maslohaslo1234-spec/DC-motor/BOM.csv

Item | Qty | Supplier | Cost/item | Total Cost | link
Enamelled copper wire 0.25 mm | 1 | AliExpress | $11.40 | $11.40 | https://pl.aliexpress.com/item/1005001693901095.html?pdp_ext_f=%7B"order"%3A"410"%2C"eval"%3A"1"%2C"fromPage"%3A"search"%7D&pdp_npi=6%40dis%21PLN%2150.60%2147.06%21%21%2183.75%2177.89%21%40210382de17941563686217380e0ccc%2112000017170269244%21sea%21PL%216848615415%21X%211%210%21n_tag%3A-29919%3Bd%3A71f28d94%3Bm03_new_user%3A-29895%3BpisId%3A5000000220770329&curPageLogUid=fweTSyffKTfp&utparam-url=scene%3Asearch%7Cquery_from%3A%7Cx_object_id%3A1005001693901095%7C_p_origin_prod%3A&gatewayAdapt=glo2pol
A3144 Hall sensor | 1 | AliExpress | $1.95 | $1.95 | https://pl.aliexpress.com/item/1005007195591707.html?mp=1
608ZZ bearings | 1 | AliExpress | $5.62 | $5.62 | https://pl.aliexpress.com/item/1005008528575310.html?pdp_ext_f=%7B"order"%3A"63"%2C"eval"%3A"1"%2C"fromPage"%3A"search"%7D&pdp_npi=6%40dis%21USD%216.22%215.62%21%21%2141.24%2137.25%21%402103956a17941568683062633e0e8b%2112000045574006522%21sea%21PL%216848615415%21X%211%210%21n_tag%3A-29919%3Bd%3A71f28d94%3Bm03_new_user%3A-29895&curPageLogUid=xlfpEw6IfKr7&utparam-url=scene%3Asearch%7Cquery_from%3A%7Cx_object_id%3A1005008528575310%7C_p_origin_prod%3A
Neodymium disc magnets 10 x 3 mm N52 | 1 | AliExpress | $8.36 | $8.36 | https://pl.aliexpress.com/item/1005010805205054.html?pdp_ext_f=%7B"order"%3A"238"%2C"eval"%3A"1"%2C"fromPage"%3A"search"%7D&pdp_npi=6%40dis%21USD%213.51%213.14%21%21%213.51%213.14%21%400b15834017941571913294615e0cb6%2112000053556705897%21sea%21PL%216848615415%21X%211%210%21n_tag%3A-29919%3Bd%3A71f28d94%3Bm03_new_user%3A-29895&curPageLogUid=AB1SDarjmCf2&utparam-url=scene%3Asearch%7Cquery_from%3A%7Cx_object_id%3A1005010805205054%7C_p_origin_prod%3A
Estimated total shipping | 1 |  |  | $2.50
