maslohaslo1234-spec/DC-motor/cad/STEP/Assembly 1.step

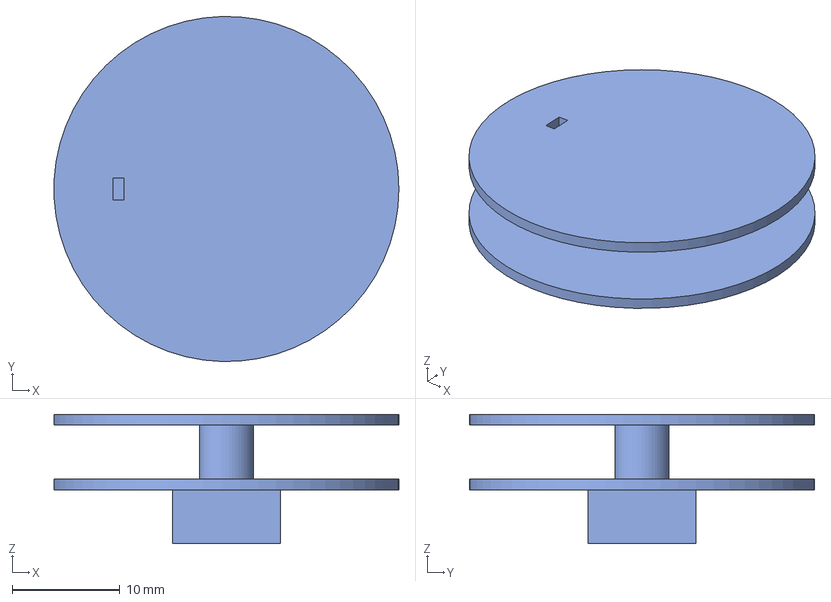
[picture p1: CAD file, 2026-11-08]
cad/STEP/Assembly 1.step
32.0 x 32.0 x 12.0 mm
