maslohaslo1234-spec/DC-motor/cad/STEP/rotor.step

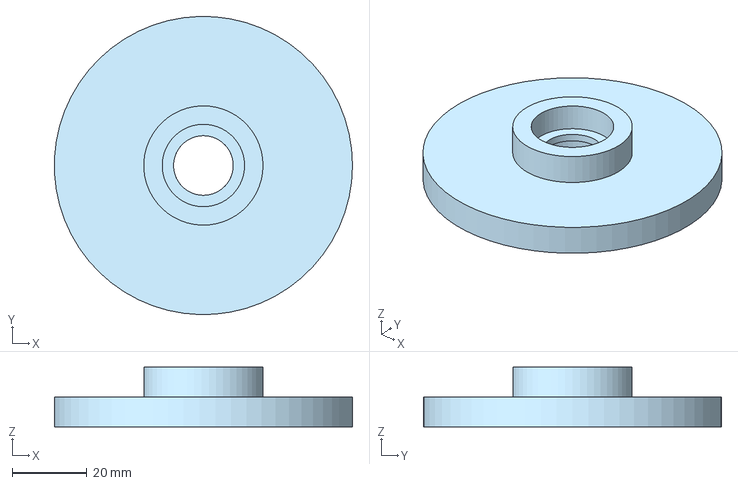
[picture p2: CAD file, 2026-11-08]
cad/STEP/rotor.step
79.9 x 80.0 x 16.0 mm
