maslohaslo1234-spec/DC-motor/cad/STEP/spacer_9.step

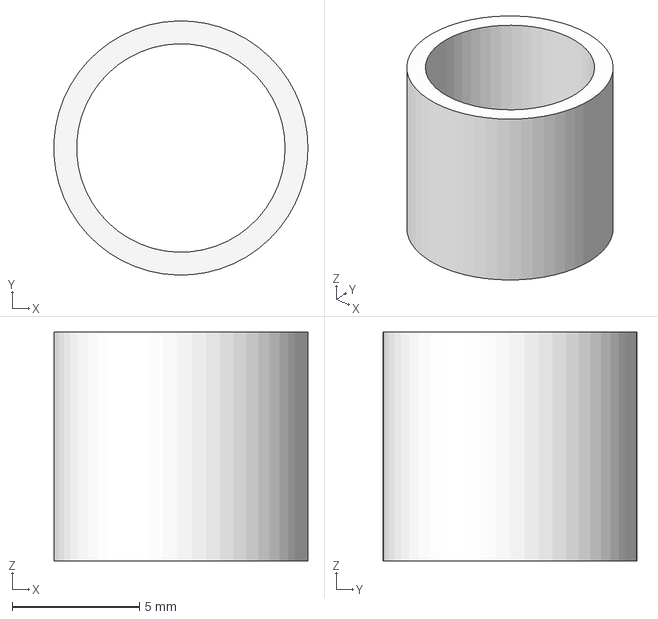
[picture p3: CAD file, 2026-11-08]
cad/STEP/spacer_9.step
9.99 x 10.00 x 9.00 mm
