maslohaslo1234-spec/DC-motor/cad/STEP/spacer_2.step

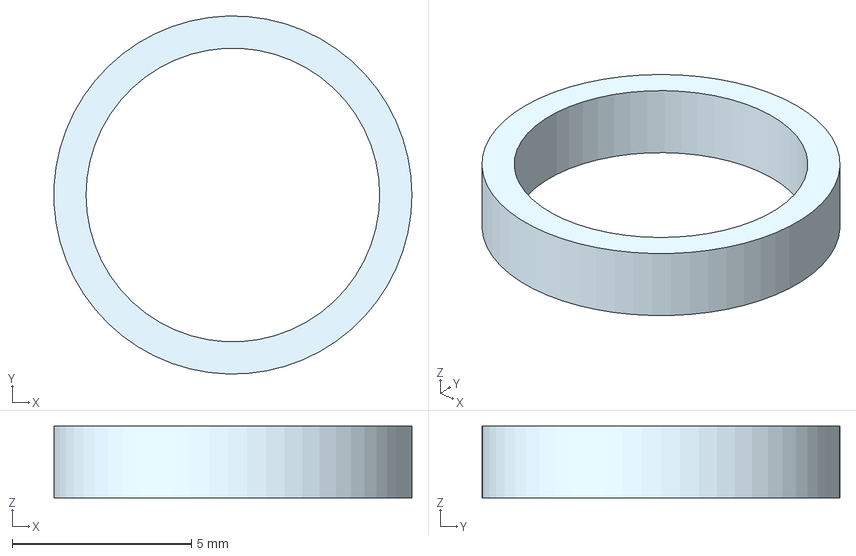
[picture p4: CAD file, 2026-11-08]
cad/STEP/spacer_2.step
9.99 x 10.00 x 2.00 mm
