maslohaslo1234-spec/DC-motor/cad/STEP/base.step

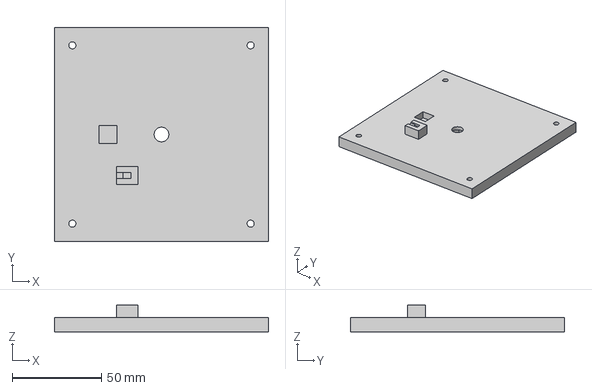
[picture p5: CAD file, 2026-11-08]
cad/STEP/base.step
120.0 x 120.0 x 15.0 mm
