maslohaslo1234-spec/DC-motor/(list of files, cad)

Other CAD files:
cad/STEP/bobbin.step
cad/STL/base.stl
cad/STL/bobbin.stl
cad/STL/rotor.stl
cad/STL/spacer_2.stl
cad/STL/spacer_9.stl
