maslohaslo1234-spec/DC-motor/schematic/DC motor.kicad_sch

## KiCad design schematic/DC motor.kicad_sch (2026-11-08)

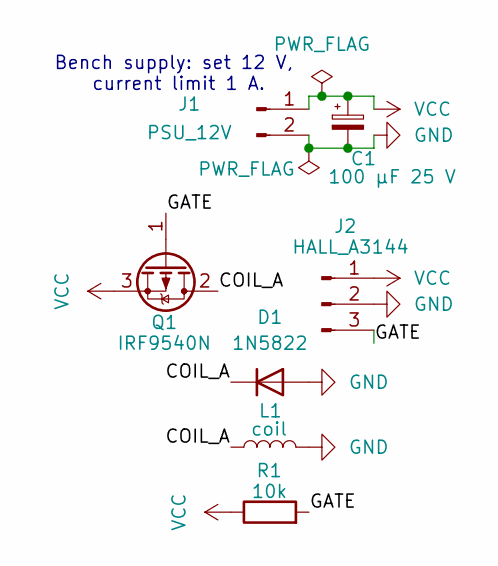
[picture p7: schematic DC motor.kicad_sch]

Parts:
C1: 100 µF 25 V; PLCC-44_16.6x16.6mm_P1.27mm
D1: 1N5822
J1: PSU_12V
J2: HALL_A3144
L1: coil; TO-220-3_Vertical
Q1: IRF9540N; TO-220-3_Vertical
R1: 10k

Connections:
COIL_A: D1.1 (K), L1.1, Q1.2 (D)
GATE: J2.3, Q1.1 (G), R1.2
GND: C1.2, D1.2 (A), J1.2, J2.2, L1.2
VCC: C1.1, J1.1, J2.1, Q1.3 (S), R1.1

Notes on the sheet:
Bench supply: set 12 V, current limit 1 A.
